Silverlode76/SmartGarden/hardware/schematics/lilygo-t3/lilygo-t3-v1.6.1-pinout.png

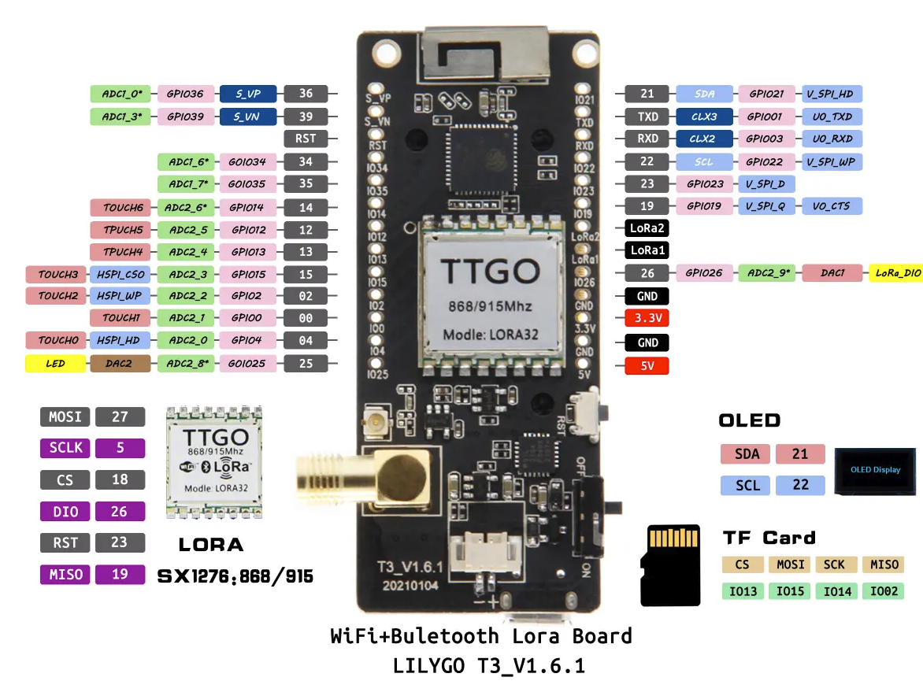
hardware/schematics/lilygo-t3/lilygo-t3-v1.6.1-pinout.png
