Silverlode76/SmartGarden/docs/product/SmartGarden-Pitch.pptx

🌱

SmartGarden

Off-Grid Smart Gardening Ökosystem

Solar-betrieben · LoRaWAN-vernetzt · Kein WLAN · Kein Strom nötig

Oliver Schmoll · Technical Product Manager · 2026

## Slide 2

Das Problem

🌱

Der Gärtner

- Pflanzen sterben im Urlaub
- Lösungen brauchen Wasserhahn mit Druck
- Off-Grid = keine funktionierende Lösung

🔒

Der Laubenbesitzer

- Einbrüche in Gartenlauben nehmen zu
- Wildkamera: Foto ja — Sofort-Alarm nein
- Keine Alarmanlage ohne Strom + WLAN

🏗️

Der Gewerbetreibende

- Baumaschinen, Holz, Weinberge gestohlen
- GSM-Alarme teuer + monatliche Kosten
- Kein LoRaWAN-Angebot am Markt

## Slide 3

Zwei spezialisierte Produkte

🌱 SmartGarden Garden Home

~65€ · Irrigator Node

- Bodenfeuchte messen
- Automatisch pumpen
- Per App steuern

Kein Wasserhahn · Solar · LoRaWAN

🔒 SmartGarden Guard Home

~45€ · Guard Node

- Bewegung + Erschütterung erkennen
- Sofortiger Push-Alarm aufs Handy
- Ohne WLAN · ohne Monatskosten

Kein WLAN · Solar · Jahre ohne Wartung

🌱🔒 SmartGarden Bundle ~100€ · Irrigator + Guard · Eine App · Ein Gateway

## Slide 4

Marktlücke — niemand hat alles

Feature

MIYO (~250€)

Gardena AquaBloom (~80€)

SmartGarden (~65€)

Pumpe (kein Wasserhahn)

❌

✅

✅

App / Fernzugriff

✅

❌

✅

Bodenfeuchtesensor

✅

❌

✅

LoRaWAN (kein WLAN)

✅

❌

✅

Einbruchalarm / PIR

❌

❌

✅

Open Source

❌

❌

✅

Preis

~250€

~80€

~65€

## Slide 5

Marktpotenzial Europa

4,2 Mio.

Off-Grid Standorte
in Europa

862 Mio. €

TAM Hardware
Europa

3,0 Mio. €

SaaS ARR
bei 2% Penetration

## Slide 6

Der Markt wird konsolidiert

Ring

→ Amazon 2018

~1 Mrd. $

Consumer Security IoT

Netatmo

→ Legrand 2018

~70 Mio. €

Smart Home IoT

Gardena

→ Husqvarna lfd.

>800 Mio. € Umsatz

Bewässerungssysteme

MIYO

→ Startup aktiv

~5 Mio. € Finanzierung

LoRaWAN Bewässerung

Niemand hat das off-grid Segment mit Pumpe + Alarm — das ist die Lücke.

## Slide 7

Technologie-Stack

☀️ Solar 6W + 2× 18650
Autarke Stromversorgung

↓

←

🌱 Garden Node
Bodenfeuchte + 12V Pumpe

TTGO LoRa32 V2.1
ESP32 + SX1276 · 868 MHz

→

🔒 Guard Node
PIR AM312 + SW-420

↓

LoRaWAN 868 MHz
TTN Gateway

→

Cloud Backend
REST API + Regelwerk

→

📱 App
iOS + Android (Flutter)

KiCad 10 Schaltplan fertig · ERC: 0 Errors · Open Source: github.com/Silverlode76/SmartGarden

## Slide 8

Roadmap

TP4056 → CN3791, STM32 → ESP32 — Erkenntnisse dokumentiert

✅

v0.0 (2025)

Prototyp STM32 + SX1276

✅

v0.1 (2026 Q1)

ERC: 0 Errors · 5 Blöcke · Open Source auf GitHub

KiCad Schaltplan + BOM + Anleitung

🔄

v0.2 (2026 Q2)

Garden Home Prototyp

Pumpe + Bodenfeuchte + LoRaWAN + Deep Sleep

⬜

v0.3 (2026 Q3)

Guard Home Prototyp

PIR + Vibration + AND-Logik + Push-Alarm

⬜

v0.4 (2026 Q3)

App MVP (Flutter)

Beide Nodes · Push-Alarm · iOS + Android

⬜

v1.0 (2027 Q2)

Markteinführung

Amazon FBA · Bundle · App Store Release

## Slide 9

Go-to-Market in 4 Phasen

2026

DIY & Community

- GitHub Open Source
- Maker-Blogs + YouTube
- Ziel: 100 Nodes

1

2026–2027

Kleingartenvereine

- 1 Gateway = ganzer Verein
- Viral: 1 Pilot → alle
- Ziel: 10 Pilotvereine

2

2027

Amazon FBA

- DE + AT + CH
- Hornbach / Baumarkt
- Ziel: 5.000 Nodes/Jahr

3

2028+

B2B & OEM

- Guard Field: Winzer/Baustellen
- OEM-Lizenz an Hersteller
- Ziel: Lizenzeinnahmen

4

## Slide 10

Erfahrung

22+ Jahre Automotive (Continental)

Ausbildung

Oliver
Schmoll

Technical Product Manager

Diplom-Ingenieur Informationstechnologie

Sprachen

Deutsch · Englisch · Französisch

Zertifizierungen

Microsoft AI PM · AWS Cloud · NVIDIA Gen AI

SmartGarden

Hardware · Firmware · Strategie · Open Source

🔗 github.com/Silverlode76/SmartGarden
🔗 linkedin.com/in/oliver-schmoll-8b4109273
