Silverlode76/SmartGarden/hardware/schematics/v0.0-gateway/STM32_LoRa_Wifi_Gateway_Schaltplan.png

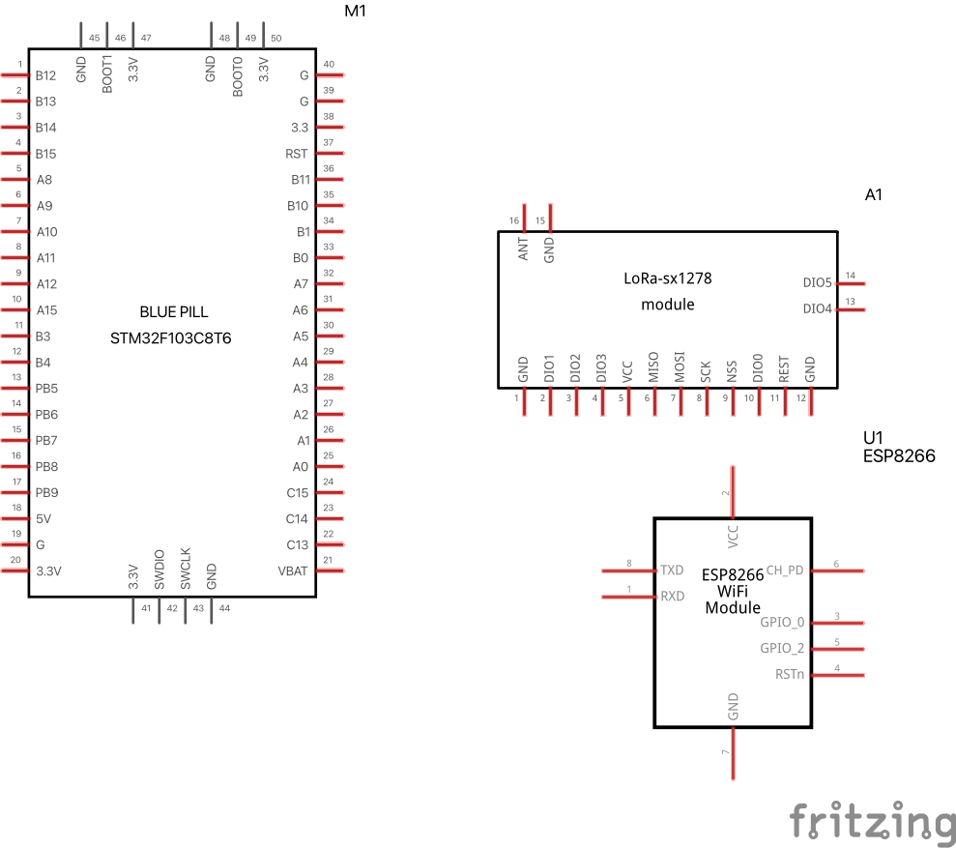
hardware/schematics/v0.0-gateway/STM32_LoRa_Wifi_Gateway_Schaltplan.png
