Silverlode76/SmartGarden/hardware/bom/v0.0-stm32-prototype-bom.md

# Stückliste — Prototyp v0.0 (STM32 + SX1278)

**Datum:** 2025 (genaues Datum unbekannt)  
**Designer:** Oliver Schmoll  
**Tool:** Fritzing (Lochrasterplatine)  
**Status:** Archiviert — abgelöst durch v0.1 (TTGO LoRa32)  
**Erkenntnisse:** Dokumentiert in [ADR-001](../../docs/architecture/ADR-001-MCU-Auswahl.md)

## Quelldokumente (archiviert)

| Datei | Beschreibung |
|---|---|
| [`STM32_LoRa_Slave_Steckplatine.pdf`](STM32_LoRa_Slave_Steckplatine.pdf) | Fritzing Steckplatinen-/Lochrasteransicht |
| [`STM32_LoRa_Slave_Schaltplan.pdf`](STM32_LoRa_Slave_Schaltplan.pdf) | Fritzing Schaltplan |

> Diese Dateien sind die **Primärquelle** für den v0.0-Prototypen.

---

## Stückliste

| Ref. | Bezeichnung | Typ | Eigenschaften | Menge |
|---|---|---|---|---|
| A1 | LoRa SX1278 Modul | LoRa Transceiver Breakout | SX1278; THT; 433 MHz (!); Pinabstand 2,54mm | 1 |
| Bauteil1 | GY-BME280 | Barometrischer Drucksensor | Temperatur + Luftfeuchte + Luftdruck; I2C; 3,3V | 1 |
| Bauteil2 | Solarzelle | Photovoltaik-Zelle (klein) | 1,5V / 1mA (0,0015W); Einzelzelle | 1 |
| Bauteil3 | Solarzelle | Photovoltaik-Zelle (klein) | 1,5V / 1mA (0,0015W); Einzelzelle | 1 |
| J1 | Female Header 4-polig | Steckverbinder | THT; 2,54mm; 4-Pin; für Sensor-Breakout | 1 |
| J2 | Female Header 4-polig | Steckverbinder | THT; 2,54mm; 4-Pin; für Sensor-Breakout | 1 |
| M1 | STM32F103C8T6 Blue Mini Board | Mikrocontroller-Board | „Blue Pill"; ARM Cortex-M3; 72MHz; 64KB Flash; 20KB RAM | 1 |
| R1 | Widerstand 10 kΩ | Widerstand | ±5%; 0,25W; THT; 4-Band; 400mil — I²C Pull-up SDA | 1 |
| R2 | Widerstand 10 kΩ | Widerstand | ±5%; 0,25W; THT; 4-Band; 400mil — I²C Pull-up SCL | 1 |
| TP1 | TP4056 | LiPo Laderegler | DIP-6; THT; max. 1A Ladestrom; Vmin ~4,5V Eingang | 1 |
| U1 | LiPo 110mAh | Lithium-Polymer Akku | 3,7V; 110mAh (= 0,407 Wh); interne R = 0,1Ω; Paket lipo-110 | 1 |
| U2 | Mini-360 DC-DC Buck Converter | Spannungsregler (Abwärtswandler) | Eingang bis 23V; Ausgang einstellbar; THT-Modul; kein MPPT | 1 |

---

## Gesamtkosten (geschätzt)

| Position | Kosten ca. |
|---|---|
| STM32F103C8T6 Blue Pill | ~3,50 € |
| LoRa SX1278 Modul | ~3,00 € |
| GY-BME280 Breakout | ~3,00 € |
| TP4056 Laderegler | ~0,50 € |
| Mini-360 Buck Converter | ~1,50 € |
| LiPo 110mAh | ~3,00 € |
| 2× Solarzelle | ~2,00 € |
| Sonstiges (R, Stecker, PCB) | ~2,00 € |
| **Gesamt** | **~18,50 €** |

---

## Schaltungskonzept (aus Fritzing-Steckplatine)

```
[2× Solarpanel, je ~3–3,5V OC]   In Reihe: ~6V / "7V" OC (Fritzing-Label)
             |
    [Mini-360 Buck Converter]      Eingang: ~6V Solar
         "6V" Label                Ausgang: einstellbar ~5V → für TP4056
             |
       [TP4056 Laderegler]         Benötigt ~4,5–5V Eingang; lädt LiPo
             |
     [LiPo 110mAh 3,7V]           Akku-Typ: 6SP 061225
             |                     (direkter GND-Anschluss an Lochrasterplatine)
             └─────────────────────────────────────────┐
                                                        |
[Lochrasterplatine]                                     |
   [STM32F103C8T6 Blue Pill] ←────────── 3,3V (vom 3V3-Pin des Blue Pill)
          │
          ├──I²C (SDA/SCL + 2× 10kΩ Pull-up)────[GY-BME280 (lila)]
          │
          └──SPI (MOSI/MISO/SCK/NSS + DIO0/DIO1)──[SX1278 LoRa Modul (blau rechts)]
                                                         → 433 MHz proprietär

Debug-Ausgang: USART3 → PB10 (TX) / PB11 (RX)
```

> **Hinweis zu Spannungsannotationen:** In der Fritzing-Steckplatine sind die Labels  
> „6V" und „7V" vom Designer manuell gesetzt. „7V" = Solar-Leerlaufspannung (OC),  
> „6V" = Betriebsspannung an Mini-360-Eingang. Die Fritzing-Bauteilbibliothek listet  
> die Solar-Zellen mit „1,5V/1mA" (Standardwert des Fritzing-Bauteils) — das spiegelt  
> **nicht** die reale Betriebsspannung wider. Tatsächlich verwendete Panels: ~3V/Stück  
> in Reihe = ~6V, aber mit sehr geringem Strom → TP4056 arbeitete grenzwertig.

---

## Erkenntnisse aus diesem Prototyp

### ✅ Was funktionierte

- STM32F103C8T6 grundsätzlich lauffähig
- BME280 liefert gute Messwerte (Temp, Feuchte, Luftdruck)
- LoRa-Kommunikation (proprietäres Protokoll) funktionsfähig
- Konzept der solarbetriebenen Node validiert

### ⚠️ Kritische Probleme

| Problem | Ursache | Lösung in v0.1 |
|---|---|---|
| **SX1278 = 433 MHz** (nicht EU868) | SX1278 Frequenzbereich 137–525 MHz → kein LoRaWAN EU868 möglich | TTGO LoRa32 mit SX1276 (137–1020 MHz), EU868-fähig |
| **Solarzellen viel zu schwach** | 2× 1,5V / 1mA in Reihe = 3,0V / 1mA = **0,003W** — für Laderegler wertlos | 6W 6V Solarpanel (~1A) |
| **TP4056 lädt nicht bei Schwachlicht** | TP4056 benötigt Vmin ~4,5V — 3V Solarspannung reicht nicht | CN3791 MPPT startet ab ~4V, effizienter bei diffusem Licht |
| **Kein MPPT** | Mini-360 ist einfacher Buck-Converter, kein Maximum-Power-Point-Tracking | CN3791 MPPT-IC |
| **110mAh viel zu klein** | 110mAh bei ~5mA Standby = ~22h Autonomie ohne Solar | 2× 18650 (~5000mAh) → ~1000h Autonomie |
| **Kein LoRaWAN** | Eigenes proprietäres Protokoll, kein TTN möglich | LoRaWAN + MCCI LMIC Library |
| **STM32 Toolchain komplex** | STM32CubeIDE, HAL, manuelle SPI-Konfiguration für SX1278 | ESP32 + Arduino Framework → schnellere Iteration |

### ❌ Warum abgelöst

Der Prototyp hat bewiesen, dass das **Konzept** funktioniert.  
Die **Plattform** (STM32 + SX1278 + TP4056 + 110mAh) ist für ein Outdoor-Solar-Produkt ungeeignet.  
→ Vollständiger Plattformwechsel auf ESP32 + SX1276 (TTGO LoRa32) für v0.1.

---

## Abgrenzung zu v0.1 BOM

| Parameter | v0.0 (STM32) | v0.1 (TTGO LoRa32) |
|---|---|---|
| MCU | STM32F103C8T6 | ESP32 (im TTGO) |
| LoRa | SX1278 (433 MHz) | SX1276 (868 MHz, EU) |
| Protokoll | Proprietär | LoRaWAN / TTN |
| Laderegler | TP4056 (kein MPPT) | CN3791 MPPT |
| Akku | LiPo 110mAh | 2× 18650 ~5000mAh |
| Solar | 2× 1,5V/1mA = 3mW | 6W 6V Panel ~1A |
| Toolchain | STM32CubeIDE + HAL | PlatformIO + Arduino |
| Autonomie (ohne☀️) | ~22h | ~1000h (~42 Tage) |
| BOM-Kosten | ~18,50€ | ~35–50€ |

---

> **Hinweis zu ADR-001:** In ADR-001 (MCU-Auswahl) wurde der Prototyp aus dem Gedächtnis beschrieben.  
> Diese BOM ist die Primärquelle (Fritzing-Exportdatei). Abweichungen:  
> - ADR-001 nennt „SX1276" — tatsächlich verbaut: **SX1278** (433 MHz)  
> - ADR-001 nennt „1× 18650" — tatsächlich verbaut: **LiPo 110mAh**  
> - ADR-001 nennt „2× Solarpanel 6V" — tatsächlich verbaut: **2× Zelle 1,5V/1mA**
