Silverlode76/SmartGarden/hardware/schematics/sensor-node/Schematic.pdf

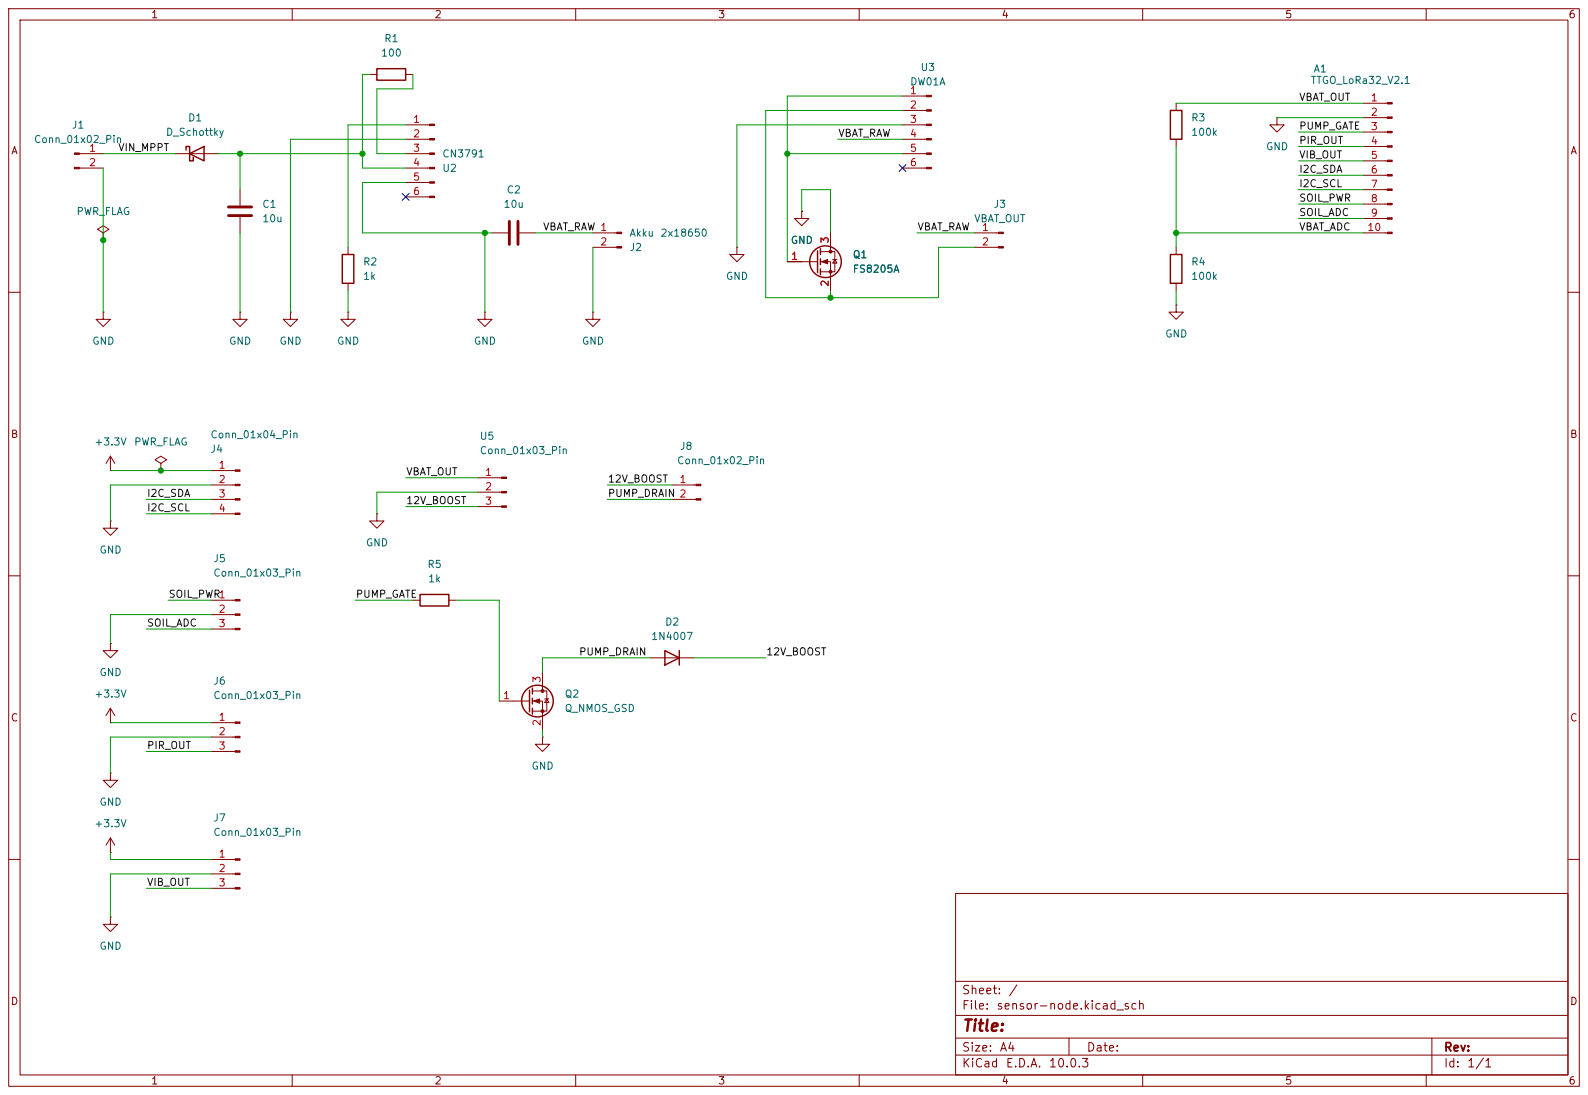
[picture p3: page 1]

Size: A4 | Rev:
KiCad E.D.A. 10.0.3 | Id: 1/1
