Silverlode76/SmartGarden/hardware/schematics/v0.0-gateway/STM32_LoRa_Wifi_Gateway_etch_copper_bottom.pdf

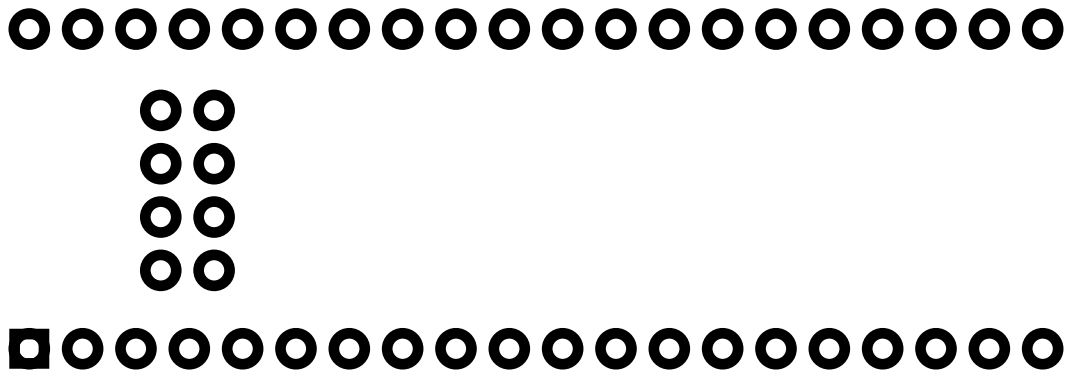
[picture p4: page 1]
