Silverlode76/SmartGarden/hardware/schematics/v0.0-gateway/STM32_LoRa_Wifi_Gateway_etch_silk_top.pdf

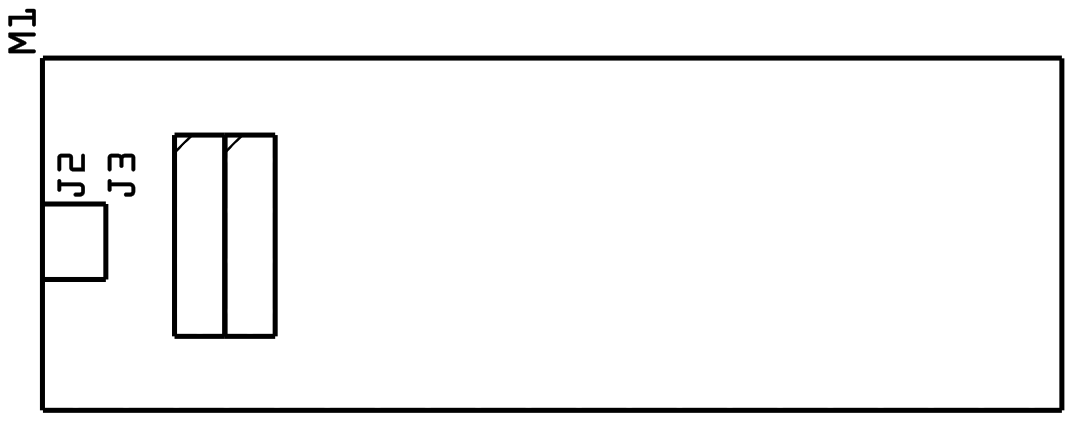
[picture p5: page 1]
