Silverlode76/SmartGarden/hardware/schematics/v0.0-stm32-slave/STM32_LoRa_Slave_Schaltplan.pdf

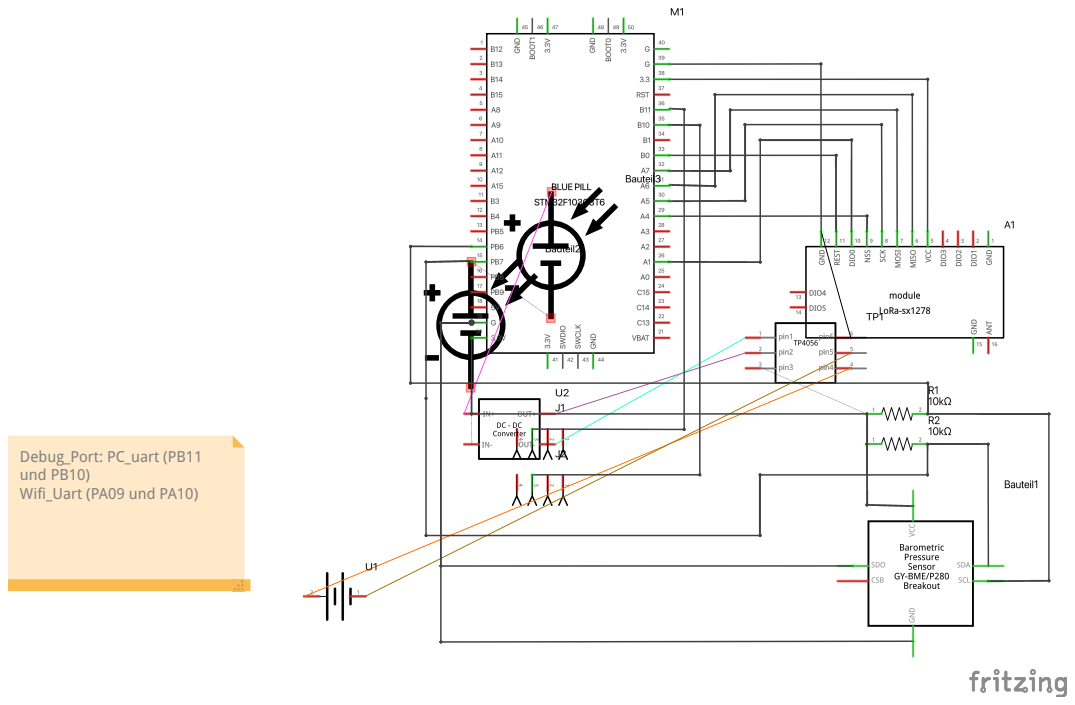
[picture p6: page 1]
Debug_Port: PC_uart (PB11 und PB10) Wifi_Uart (PA09 und PA10)
