Silverlode76/SmartGarden/hardware/schematics/v0.0-stm32-slave/STM32_LoRa_Slave_Steckplatine.pdf

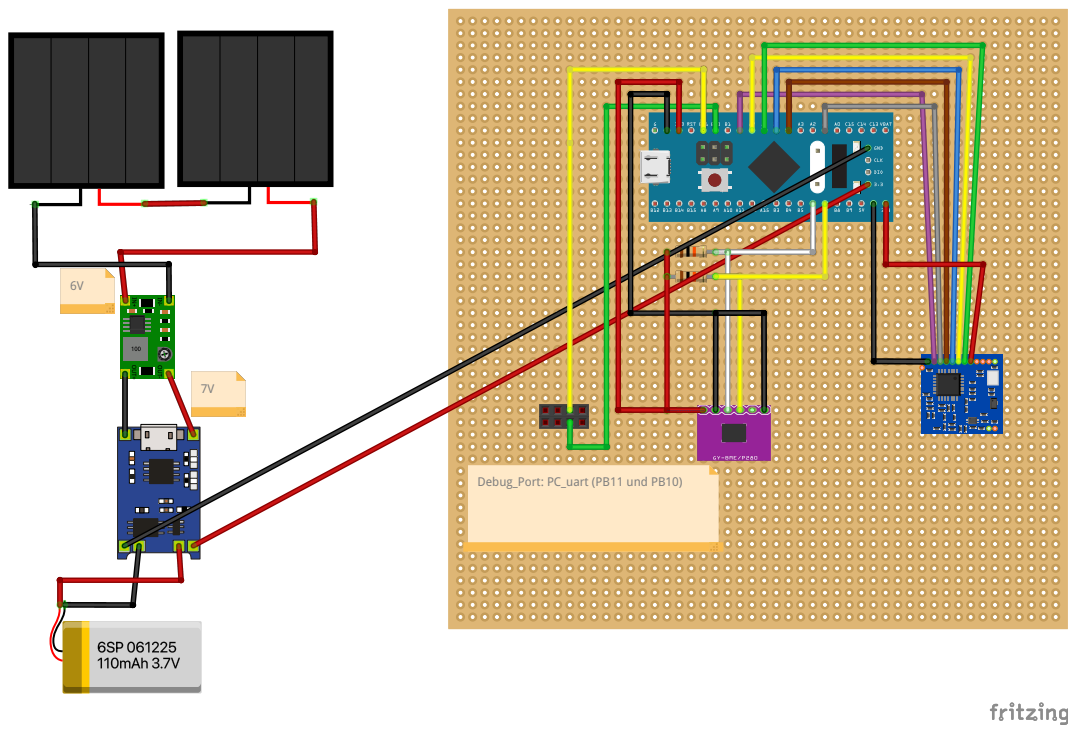
[picture p7: page 1]
Debug_Port: PC_uart (PB11 und PB10)
