Silverlode76/SmartGarden/(list of files, drawings)

Other design files:
hardware/schematics/v0.0-gateway/STM32_LoRa_Wifi_Gateway.fzz
