Silverlode76/SmartGarden/hardware/schematics/sensor-node/sensor-node.kicad_sch

## KiCad design hardware/schematics/sensor-node/sensor-node.kicad_sch (2026-05-25)

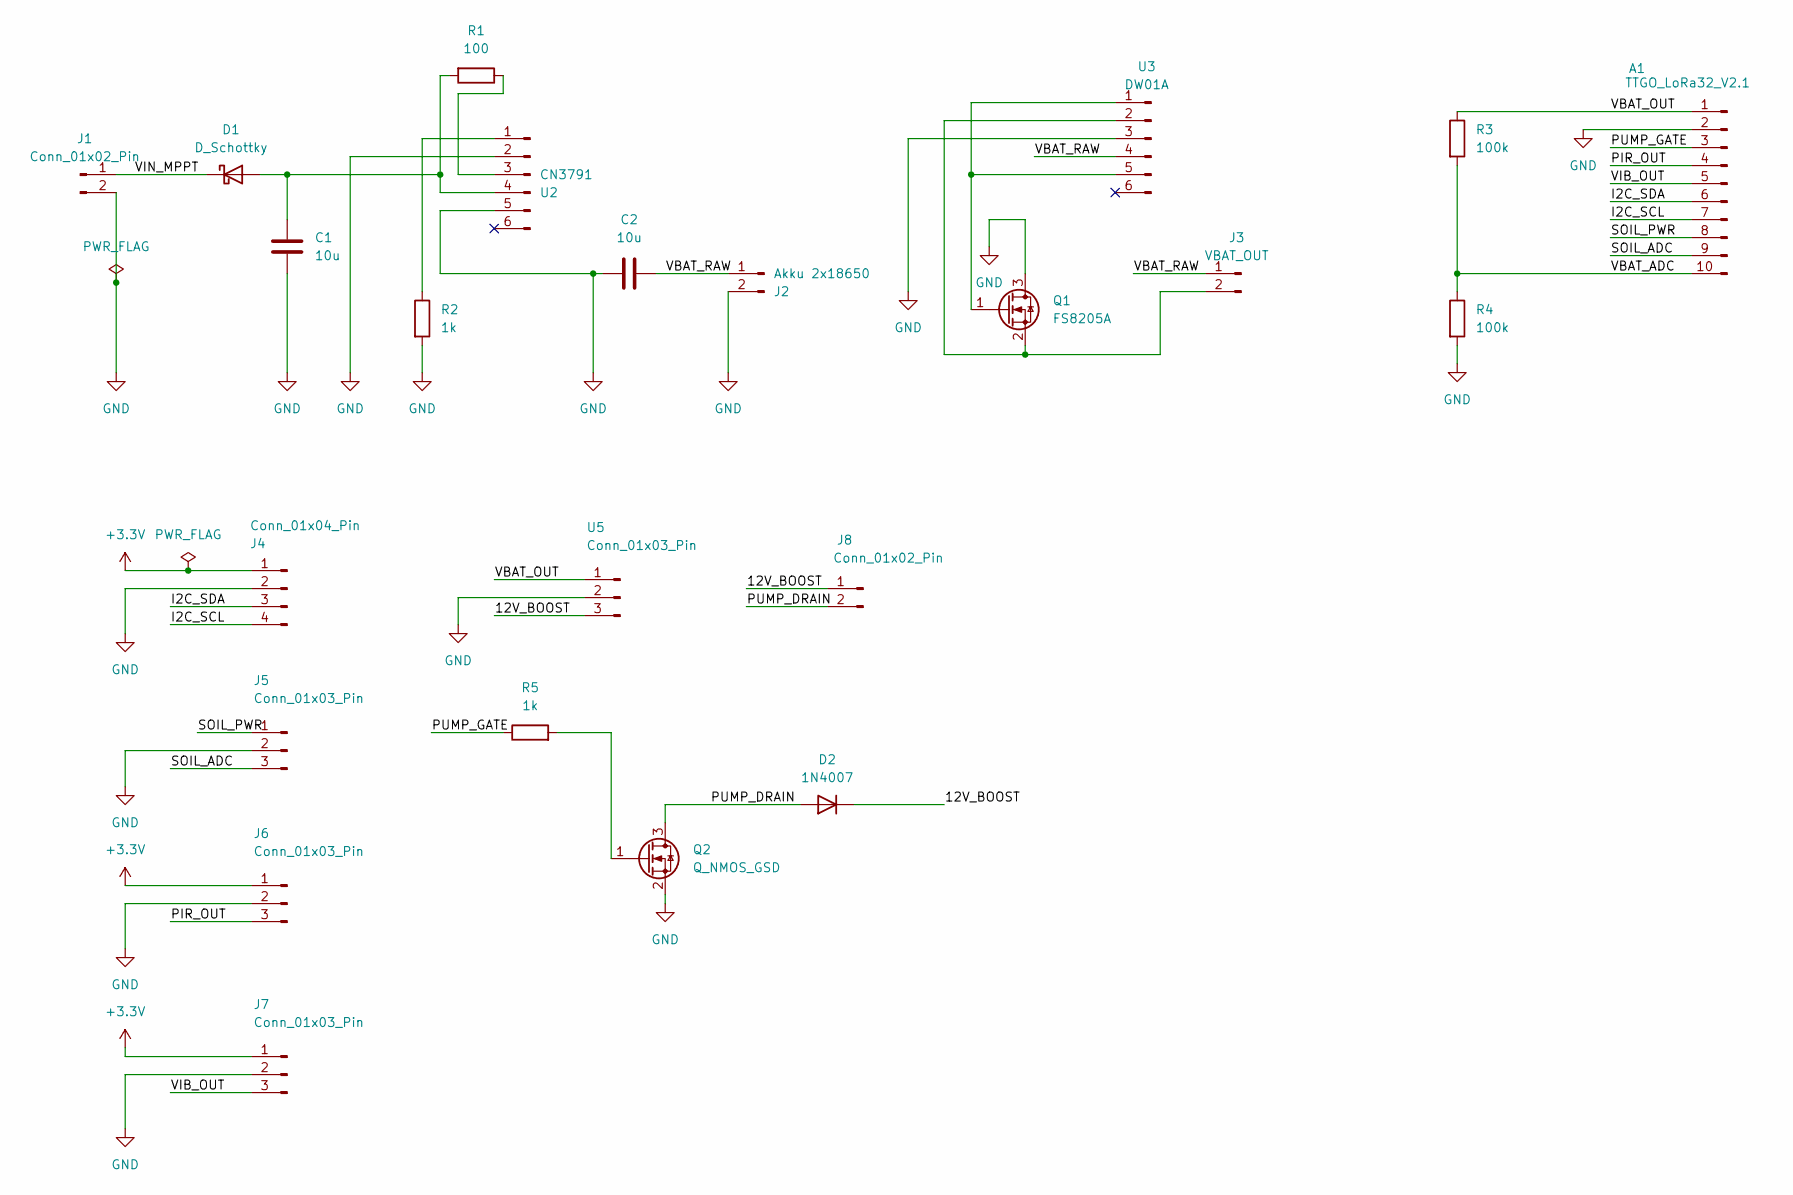
[picture p8: schematic sensor-node.kicad_sch]

Parts:
A1: TTGO_LoRa32_V2.1
C1, C2: 10u
D1: D_Schottky
D2: 1N4007; D_DO-41_SOD81_P10.16mm_Horizontal
J1, J8: Conn_01x02_Pin
J2: Akku 2x18650
J3: VBAT_OUT
J4: Conn_01x04_Pin
J5, J6, J7: Conn_01x03_Pin
Q1: FS8205A
Q2: Q_NMOS_GSD
R1: 100
R2, R5: 1k
R3, R4: 100k
U2: CN3791
U3: DW01A
U5: Conn_01x03_Pin

Connections:
12V_BOOST: D2.1 (K), J8.1, U5.3
+3.3V: J4.1, J6.1, J7.1
GND: A1.2, C1.1, C2.2, J1.2, J2.2, J4.2, J5.2, J6.2, J7.2, Q1.3 (D), Q2.2 (S), R2.2, R4.2, U2.2, U2.5, U3.3, U5.2
I2C_SCL: A1.7, J4.4
I2C_SDA: A1.6, J4.3
unnamed: C1.2, D1.2 (A), R1.2, U2.4
unnamed: J3.2, Q1.2 (S), U3.2
unnamed: Q1.1 (G), U3.1, U3.5
unnamed: Q2.1 (G), R5.2
unnamed: R1.1, U2.3
unnamed: R2.1, U2.1
PIR_OUT: A1.4, J6.3
PUMP_DRAIN: D2.2 (A), J8.2, Q2.3 (D)
PUMP_GATE: A1.3, R5.1
SOIL_ADC: A1.9, J5.3
SOIL_PWR: A1.8, J5.1
VBAT_ADC: A1.10, R3.2, R4.1
VBAT_OUT: A1.1, R3.1, U5.1
VBAT_RAW: C2.1, J2.1, J3.1, U3.4
VIB_OUT: A1.5, J7.3
VIN_MPPT: D1.1 (K), J1.1
