Silverlode76/SmartGarden/firmware/v0.0-stm32-node/Core/Inc/main.h

#define LED_Pin GPIO_PIN_13
#define LED_GPIO_Port GPIOC
#define DIO0_Pin GPIO_PIN_1
#define DIO0_GPIO_Port GPIOA
#define DIO0_EXTI_IRQn EXTI1_IRQn
#define NSS_Pin GPIO_PIN_4
#define NSS_GPIO_Port GPIOA
#define RST_Pin GPIO_PIN_0
#define RST_GPIO_Port GPIOB
