Silverlode76/SmartGarden/(commit log)

2026-05-24 initiale Projektstruktur mit Docs, Requirements und Architecture
2026-05-24 docs: ADR-001 MCU-Entscheidung und Prototyp-Erkenntnisse dokumentieren
    Erfahrungen aus dem v0.0-Prototyp (STM32 + SX1276 + BME280) fließen
    in die Architekturentscheidungen für v0.1 ein: Wechsel zu ESP32 mit
    integriertem LoRa-Modul, LoRaWAN statt eigenem Protokoll, BME280 als
    Standard-Sensor statt DHT22.
2026-05-25 feat: Sensor-Node v0.1 Schaltplan + Hardware-Architektur vollständig
    ## Hardware-Architektur (docs/)
    - README: Off-Grid Smart Irrigation Positionierung, Gardena AquaBloom als Wettbewerber ergänzt
    - hardware-overview.md: Vollständige Schaltplan-Dokumentation (5 Blöcke: Ladekreis, Akkuschutz, TTGO, Sensoren, Pumpe)
    - ADR-001: Prototyp-Erkenntnisse dokumentiert (STM32→ESP32, TP4056→CN3791 MPPT, Schwachlicht-Problem)
    - competitive-analysis.md: Gardena AquaBloom Analyse, Off-Grid Zielgruppen, 3-Wege USP-Vergleich
    - agent-prompts.md: Architekt-Agent mit aktuellem Tech-Stack (CN3791, AM312, BME280, 2P-Akku)
    ## KiCad Schaltplan (hardware/schematics/sensor-node/)
    - Block A: CN3791 MPPT Ladek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
    [sensor-node-bom.csv, sensor-node.kicad_sch]
2026-05-25 Sensor-Node v0.1 — KiCad Schaltplan + Hardware-Architektur
    ## Was wurde gemacht
    - KiCad Schaltplan sensor-node vollständig gezeichnet (5 Blöcke, ERC: 0 Errors)
    - Hardware-Architektur Dokumentation aktualisiert
    - BOM (Stückliste) erstellt ~50€ pro Node
    ## Schaltplan Blöcke
    - **Block A:** CN3791 MPPT Ladekreis (SS14 + R_MPPT + R_PROG)
    - **Block B:** DW01A + FS8205A Akkuschutz (OVP/UVP/OCP)
    - **Block C:** TTGO LoRa32 V2.1 (10 GPIOs + VBAT Spannungsteiler)
    - **Block D:** Sensoren (BME280, Bodenfeuchte, AM312 PIR, SW-420)
    - **Block E:** Pumpensteuerung (XL6009 + IRLZ44N + 1N4007)
    ## Nächste Schritte
    - [ ] Lochraster-Aufbau v0.1
    - [ ] PlatformIO Firmware-Projekt
2026-05-25 HW Layout
    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
2026-05-25 docs: Sensor-Node Aufbauanleitung (Lochraster v0.1)
    Schritt-für-Schritt Löt- und Testanleitung für alle 5 Blöcke:
    Block A (CN3791 Ladekreis), B (DW01A Akkuschutz), C (TTGO LoRa32),
    D (Sensoren), E (Pumpensteuerung XL6009 + IRLZ44N)
    Enthält: Werkzeugliste, Sicherheitshinweise, Testpunkte mit
    erwarteten Spannungen, typische Fehler & Lösungen.
2026-05-25 docs: README für Portfolio optimiert + MIT License hinzugefügt
    - Badges (License, KiCad, Platform, Status)
    - Problemstellung und Lösung klar strukturiert
    - Hardware-Architektur Tabelle mit Tech-Stack
    - Energiebudget-Tabelle
    - Prototyp-Erkenntnisse v0.0 dokumentiert
    - Vollständige Projektstruktur mit Links
    - Roadmap mit abgeschlossenen Meilensteinen
2026-05-27 Add product portfolio: Irrigator + Guard + Bundle
    Introduces two-product architecture based on physical separation of use cases:
    - Irrigator (~65€): soil sensor + pump + LoRaWAN for gardeners
    - Guard (~45€): PIR + vibration + alarm for shed/cabin owners
    - Bundle (~100€): both products for allotment garden owners with shed
    Adds docs/product/product-strategy.md with full market analysis, pricing,
    go-to-market strategy and risk assessment. Updates README and roadmap.
2026-05-27 Expand product strategy into two distinct product lines
    Garden line: Home (65€) + Pro (120€, multi-zone)
    Guard line: Home (45€) + Field (80€, vineyard/construction + wildlife camera trigger) + Asset (95€, GPS tracking for machinery)
    Key additions:
    - Wildkamera integration via optocoupler trigger output on Guard Field
    - AND-logic alarm filtering to prevent false alarms
    - Separate ECU architectures per product
    - Expanded market segments: vineyards, forestry, construction sites
    - Guard Field addresses wood theft / vineyard theft use cases
2026-05-28 Add extended market analysis to product strategy
    - European TAM: ~862M€ hardware across 4.2M off-grid sites
    - SaaS ARR projection: 756K€ (conservative) to 7.6M€ (optimistic)
    - 3-year revenue model: 35K€ → 344K€ → 1.3M€
    - Break-even analysis: ~2,000 nodes / end of 2027
    - Comparable exits: Netatmo (70M€), Ring (1B$), Gardena (800M€ revenue)
    - Competitive positioning matrix
2026-05-28 Add SmartGarden pitch deck (10 slides)
    Professional pitch deck covering:
    - Product portfolio: Garden Home + Guard Home + Bundle
    - Problem/Solution with 3 customer segments
    - Competitive analysis table (MIYO vs. Gardena vs. SmartGarden)
    - European market sizing: 4.2M sites / 862M€ TAM / 3.0M€ SaaS ARR
    - Comparable exits: Ring/Amazon, Netatmo/Legrand, Gardena/Husqvarna
    - Technology architecture flow
    - Roadmap v0.0 → v1.0
    - Go-to-Market in 4 phases
    - Developer profile
2026-05-28 Add Guard battery monitoring user stories (US-020 to US-023)
    US-008: Expand Garden battery display with full acceptance criteria
    US-020: Guard battery % + estimated remaining runtime (no solar)
    US-021: 3-tier push alarm at 25% / 10% / 3% with special low-battery payload
    US-022: Node offline detection with context (dead battery vs. possible theft)
    Key insight: last known battery level distinguishes both cases
    US-023: Charging history + maintenance reminder (like smoke detector battery)
    All Guard stories reflect batteryless design: 1-1.5 year runtime on 2x18650.
2026-05-28 Add 3-phase hardware path and Custom PCB ADR (ADR-002)
    Phase 1 (PoC): TTGO Dev-Board, BOM Guard ~47€, sell ~89€
    Phase 2 (Pilot): TTGO Bulk @12€, BOM Guard ~32€, sell ~65€
    Phase 3 (Production): Custom PCB ESP32-WROOM-32E + SX1262, BOM Guard ~18€, sell ~45€
    ADR-002: Documents why TTGO (21€ Einzelbezug) makes Guard target
    price (45€) impossible. Custom PCB via JLCPCB/PCBWay from KiCad
    Gerbers reduces BOM from ~47€ to ~18€. Rejected alternatives
    documented (bare ESP32 chip, RAK WisBlock, Nordic nRF9160, STM32).
2026-05-28 Add Garden Home PoC firmware (PlatformIO + MCCI LMIC)
    TTGO LoRa32 V2.1 — ESP32 + SX1276 — EU868 / TTN OTAA
    Features:
    - OTAA Join via TTN (The Things Network)
    - Uplink alle 60s: 1 Byte LED-Status (Port 1)
    - Downlink: LED an (0x01) / aus (0x00) / toggle (0x02)
    - OLED-Display: Join-Status, TX-Counter, RSSI, LED-State
    - Adaptive Data Rate (ADR) aktiviert
    - secrets.h in .gitignore (Credentials nie im Git)
    Nächste Schritte:
    - secrets.h aus TTN Console befüllen
    - platformio run --target upload
2026-05-28 Document v0.0 STM32 prototype BOM and correct ADR-001
    BOM source: Fritzing export from first prototype build
    Corrects ADR-001 which was written from memory:
    - LoRa chip: SX1278 (433 MHz), not SX1276 (EU868)
    - Battery: LiPo 110mAh, not 18650
    - Solar: 2× 1.5V/1mA cells (3mW total), not 6V panels
    - No MPPT: Mini-360 Buck converter only
    - Consequence: ~22h autonomy without sun, EU868 not possible
    BOM includes: STM32F103C8T6 Blue Pill, SX1278, GY-BME280,
    TP4056, LiPo 110mAh, Mini-360 Buck, 2× 10kΩ, female headers
2026-05-28 Archive v0.0 Fritzing files and document full system architecture
    Slave node (STM32 + SX1278):
    - Archive Fritzing schematic + breadboard PDFs
    - Correct power chain from image: Solar ~6V → Mini-360 Buck → TP4056 → LiPo
    - Clarify Fritzing library default (1.5V/1mA) vs actual voltage labels (6V/7V)
    - Debug UART confirmed: USART3 PB10(TX)/PB11(RX)
    Master/Gateway (ESP32 + STM32 + SX):
    - Document dual-MCU architecture: STM32 handles LoRa SPI timing,
    ESP32 handles WiFi + cloud upload, UART bridge between them
    - Document proprietary 433MHz protocol flow
    - Compare v0.0 (proprietary) vs v0.1+ (LoRaWAN/TTN) architecture
    Key learnings: dual-MCU gateway works but doesn't scale,
    proprietary prot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
2026-05-28 Correct and complete v0.0 master gateway documentation
    Key correction: Master used ESP8266 (not ESP32) as WiFi module
    - ESP8266 ESP-01 form factor, UART bridge to STM32
    - STM32 handled LoRa SPI stack + packet parsing
    - Full stack proven: LoRa → STM32 → UART → ESP8266 → Google Cloud → Flutter app
    Pin mapping documented from Fritzing schematic:
    - SX1278 SPI: PA4-PA7 + DIO0 IRQ
    - ESP8266 UART: PA9/PA10 (USART1)
    Architecture comparison added: v0.0 (proprietary) → v0.1 (LoRaWAN) → v1.0 (product)
    Key insight: Cloud+Flutter stack was already proven in v0.0
2026-05-28 Complete v0.0 architecture documentation with full system diagrams
    Revealed from architecture diagrams:
    - Gateway was Raspberry Pi + SX1302 (8-channel LoRa concentrator, not just ESP8266)
    - UUID-based device addressing (uuid1=node1, uuid2=node2, uuid3=gateway)
    - Google Cloud IoT Core as MQTT broker (bidirectional)
    - Firebase for data storage
    - Flutter app via MQTT
    - Bidirectional LoRa (uplink + downlink capable)
    Boot sequence documented (STM32+ESP8266):
    - STM32 initializes ESP8266 first
    - ESP8266 connects WiFi AP (retry loop)
    - ESP8266 connects Firebase (retry loop)
    - Only after confirmed cloud connection: STM32 inits LoRa
    - Ensures no packet loss on startup
    Key insight: v0.0 was architect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
2026-05-28 Archive v0.0 gateway firmware, Fritzing PCB and schematic
    Firmware (STM32F103C8T6 + ESP8266, STM32CubeIDE):
    - AT command sequence: CWMODE=1 → CWJAP → CIPMUX=1 → CIPSERVER:80
    - USART3 (PB10/PB11) @ 115200 baud to ESP8266
    - TCP web server on port 80 (local network access)
    - WiFi credentials REMOVED (were hardcoded in original - Lesson Learned)
    - LoRa (SX1278) was TODO - WiFi init was first milestone
    Fritzing PCB (designed Dec 24, 2024):
    - Full gateway PCB layout: copper top/bottom, silk screen
    - STM32F103C8T6 + SX1278 + ESP8266 on one board
    - .fzz source file + key PCB layer PDFs archived
    Lessons learned documented:
    - Credentials → always secrets.h + .gitignore (fixed in v0.1)
    - AT-m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
    [STM32_LoRa_Wifi_Gateway.fzz]
2026-05-28 Correct v0.0 gateway: STM32+ESP32 dual-MCU, not Raspberry Pi+SX1302
    Actual hardware (confirmed by user):
    - STM32F103C8T6 (CubeIDE HAL): LoRa SX1278 SPI stack
    - ESP32 (Arduino framework): WiFi + Firebase connectivity
    - UART bridge between STM32 and ESP32
    Firebase details from archived code:
    - DB: collectxcpandlora-default-rtdb.firebaseio.com
    - Downlink path: /sensor_commands/txpk/0/decoded_data/LED
    - ESP32 polls Firebase every 15s for LED commands
    - WiFi credentials stored in EEPROM (not hardcoded)
    Performance confirmed by user: 3km range, bidirectional
    LED control working (master sends ON/OFF, slave responds)
2026-05-28 Archive complete v0.0 STM32 LoRa node firmware (STM32_myLora)
    Full STM32CubeIDE project with MASTER/SLAVE dual-role firmware,
    HAL SPI LoRa stack (Sslman Motlaq), BME280 driver, bidirectional LED
    control protocol at 868 MHz, DIO0 interrupt-driven receive, STOP-mode
    sleep on slave. Confirmed 3 km field range.
2026-05-28 ADR-003: Pump selection — min. 3m head required, upgrade to 10W
    Prototype test revealed cheap 3-5W pump (~1.5m shutoff head) fails at
    1m lift. Documents head-flow curve constraint, updated pump spec to 10W
    with min. 3m max head. Corrects energy budget accordingly (10W pump,
    realistic 4 min/day vs. old 30 min estimate). XL6009 remains viable
    at I_in ≈ 3.4A but flagged for thermal validation.
2026-05-28 ADR-004: Switch to drip irrigation — eliminates 12V boost converter
    Drip system (1-3W, 3.7-5V pump) validated by Gardena AquaBloom (1W/3.6V/4m
    head/10 L/h). XL6009 boost converter removed from BOM. Pump cost drops from
    12€ to 5-8€; adds drip hardware (~8€). Net BOM neutral, circuit simpler.
    Autonomy without sun improves from ~21 to ~56 days. ADR-003 updated to
    reflect new pump spec (3-5V, not 12V).
2026-05-28 Add controller standby to energy budget; expose TTGO LDO quiescent current
    TTGO board deep sleep is ~5.5mA (not 0.01mA) due to AMS1117 LDO (5mA
    quiescent) and CP2104 USB-UART chip. Standby dominates energy budget at
    ~460 mWh/day — more than pump (270 mWh) + LoRa TX (180 mWh) combined.
    Custom PCB with MCP1700 LDO reduces standby to ~4 mWh/day (115× better).
    Validated by Gardena AquaBloom analysis: same pattern, standby > pump.
2026-05-28 Add Guard competitive analysis; swap roadmap to Guard-first
    competitive-analysis.md: Full Guard section added — GSM alarms,
    Daitem D22, VisorTech Solar, YoLink, 4G wildlife cameras. Matrix
    shows SmartGarden Guard is only solution combining solar + push app
    + no hub/WiFi on-site + zero monthly costs. Critical assumptions
    for field validation documented.
    product-strategy.md: Roadmap swapped — Guard Home prototype moves
    to v0.2 (simpler hardware, validates LoRaWAN pipeline, blue ocean),
    Garden Home moves to v0.3 (benefits from validated pipeline, spring
    2027 launch window).
2026-05-28 Guard PoC v0.2: TTGO LoRa32 + PIR → LoRaWAN → TTN → ntfy.sh push
    Complete PlatformIO project for Guard Home PoC:
    - main.cpp: PIR interrupt (GPIO13, RISING) → LMIC OTAA → 2-byte uplink
    (alert type + counter), 60s cooldown, LED feedback
    - platformio.ini: MCCI LMIC only (no display libs needed for Guard)
    - secrets.example.h: TTN OTAA credentials template
    - README.md: full setup guide — wiring, HC-SR501 5V caveat,
    TTN device registration, ntfy.sh webhook config, test procedure
    Known PoC limits: no deep sleep, HC-SR501 needs USB 5V,
    no watchdog. Deep sleep + AM312 + watchdog in v0.3.
2026-05-29 Fix OLED_RST pin, add LMIC config and sensor node setup guide
    - Fix OLED_RST 16 -> -1 (Pin 16 intern belegt auf TTGO, verursachte Watchdog-Reset)
    - lmic_project_config.h mit CFG_eu868, SX1276, Interrupts
    - Setup-Guide docs/architecture/setup-sensor-node.md: TTN-Onboarding,
    Byte-Reihenfolge der Keys, bekannte Probleme, Downlink-Kommandos
    [main.cpp]
2026-05-29 Add HC-SR501 PIR motion sensor with polling and pending uplink
    - PIR auf GPIO 13 (HC-SR501, 5V, Jumper L, Polling statt Interrupt)
    - Zustandsaenderung (ALARM/KLAR) loest sofortigen Uplink aus
    - Payload Byte 1: 0x01 = Bewegung, 0x00 = klar
    - motionPending Flag sendet KLAR-Uplink nach TX-Abschluss
2026-05-29 Revert main.cpp to pre-PIR version (OLED fix only)
    [main.cpp]
2026-05-29 Re-add PIR motion sensor with simple polling (no pending counter)
2026-05-29 Add Flutter mobile app with TTN MQTT live status and LED control
    - MQTT Verbindung zu TTN eu1 (Port 8883, TLS)
    - Live-Anzeige: LED-Status und Bewegungsalarm
    - LED-Steuerung per Downlink (AN/AUS/Toggle)
    - API Key ausgelagert in secrets.dart (gitignored)
    - secrets.example.dart als Vorlage eingecheckt
2026-05-30 Switch Flutter Web App to Firebase RTDB polling + add architecture docs
    - main.dart: MQTT ersetzt durch HTTP polling auf Firebase Realtime Database
    - Status-Update alle 10s via REST GET auf Firebase RTDB
    - LED-Steuerung via TTN REST API (HTTP POST mit Bearer Token)
    - Neuer Datenfluss: Node -> TTN Webhook -> Firebase RTDB -> Flutter App
    - webapp-architecture.md: Architekturdiagramm, Sequenzdiagramme,
    Payload-Format, Deployment-Anleitung
2026-06-04 Add US-024 IP65 protection requirement for Guard Node outdoor housing
2026-06-04 Add Arduino sketch, sync LMIC_setClockError fix to both versions
    - firmware/sensor-node/arduino/: Arduino IDE Version des Sketches
    - firmware/sensor-node/arduino/secrets.example.h: Key-Template
    - firmware/sensor-node/src/main.cpp: LMIC_setClockError(10%) ergaenzt
    (RX-Fenster breiter fuer zuverlaessigeren Join auf ESP32)
    [SmartGardenNode.ino, secrets.example.h]
2026-06-04 Remove LMIC_setClockError, fix Firebase latest entry sorting in Flutter App
    - Entferne LMIC_setClockError (verlangsamt Zyklus, war nicht noetig)
    - Flutter App: neuesten Eintrag per received_at sortieren statt entries.last
    - Gilt fuer src/main.cpp und arduino/SmartGardenNode.ino
    [SmartGardenNode.ino, main.cpp]
2026-06-04 Add Deep Sleep + PIR Wakeup + RTC Session Persistence (Guard v0.2)
    - Deep Sleep zwischen Uplinks (15min Timer)
    - PIR GPIO13 weckt ESP32 bei Bewegung sofort auf (steigende Flanke)
    - Session-Keys werden im RTC-Speicher gespeichert (ueberlebt Deep Sleep)
    - Kein Re-Join nach Aufwachen -> sofortiger Alarm-Uplink
    - LED-Status bleibt nach Deep Sleep erhalten (RTC_DATA_ATTR)
    - Wakeup-Grund wird erkannt (PIR/Timer/Reset)
    - Erster Boot: OTAA Join, danach nur noch RTC-Session
    Stromverbrauch-Schaetzung:
    - Aktiv (TX): ~300mA fuer ~2s alle 15min
    - Deep Sleep: ~0.15mA
    - Durchschnitt: ~0.5mA -> 2x18650 ~400 Tage
    [SmartGardenNode.ino]
2026-06-04 Fix LMIC_setSession API call and artKey typo in Guard v0.2
    - LMIC_setSession: netid 0x13 als ersten Parameter ergaenzt
    - LMIC.appKey -> LMIC.artKey korrigiert
    - LMIC_setClockError auf 30% erhoeht fuer zuverlaessigeren Join
    [SmartGardenNode.ino, main.cpp]
2026-06-04 Add US-025 waterproof prototype housing and US-026 WiFi OTA update
    - US-025 [MUST]: Spelsberg IP66 Gehaeuse fuer ersten Prototyp
    inkl. PIR-Optionen, Durchfuehrungen, Materialkostenschaetzung ~23 EUR
    - US-026 [SHOULD]: OTA Firmware-Update via WiFi bei USB-C Wartung
2026-06-04 Add PoC wiring documentation for TTGO LoRa32 V2.1
    - HC-SR501 PIR Verdrahtung (5V, GPIO13, Jumper L)
    - BME280 geplante Verdrahtung (I2C shared mit OLED)
    - I2C Bus Belegung Tabelle
    - Pin-Belegung aktueller PoC
    - Wichtige Hinweise HC-SR501 vs AM312
2026-06-04 Improve Guard v0.2 sleep behavior after TX
    - Nach TX: 10s wach bleiben fuer Downlinks, dann Deep Sleep
    - Bei aktivem PIR-Alarm: alle 30s Uplink senden bis Alarm vorbei
    - PIR-Status beim Timer-Wakeup pruefen (falls Bewegung waehrend Sleep)
    - Serial log fuer PIR-Status beim Start
2026-06-04 Fix PIR HIGH bug before Deep Sleep
    - Problem: ESP32 schlaeft wenn PIR=HIGH -> keine steigende Flanke
    -> Wakeup durch EXT0 unmoeglich solange PIR HIGH bleibt
    - Fix: vor Deep Sleep warten bis PIR=LOW (fallende Flanke)
    - Sicherheits-Timeout nach 5 Minuten (dauerhafter Alarm)
    - OLED zeigt 'Warte auf KLAR' waehrend des Wartens
    [SmartGardenNode.ino]
2026-06-04 Replace lambda with named function triggerSleep() for readability
    [SmartGardenNode.ino]
2026-06-04 Add max alarm uplink limit to prevent endless active state
    - MAX_ALARM_UPLINKS = 5 (nach 5 Alarm-Uplinks erzwungener Sleep)
    - rtcAlarmCount im RTC gespeichert (ueberlebt Deep Sleep)
    - OLED zeigt Alarm-Counter (z.B. Alarm 3/5)
    - Verhindert Duty-Cycle-Erschoepfung bei dauerhaft aktivem PIR
    [SmartGardenNode.ino]
2026-06-04 Fix EU868 channels missing in RTC session restore path
    - LMIC_setupChannel fuer alle 9 EU868 Kanaele vor beiden Pfaden gesetzt
    - Gilt jetzt fuer OTAA Join UND RTC-Session-Restore
    - Verhindert falsches Kanalverhalten nach Deep Sleep Wakeup
    [SmartGardenNode.ino]
2026-06-04 Update state machine docs for Guard v0.2 with Deep Sleep
    - Haupt-State Machine: Deep Sleep Zyklus komplett neu
    - Wakeup-Logik Flowchart (PIR/Timer/Reset)
    - Alarm-Logik Flowchart (alarmCount, triggerSleep)
    - RTC-Speicher Tabelle mit Erklaerung
    - Energiebudget (~90 Tage mit 2x18650)
    - Bekannte Einschraenkungen mit Status
2026-06-07 Guard v0.2: Rejoin after each sleep instead of RTC session restore (#1)
    * Replace RTC session restore with fresh OTAA join after each sleep
    RTC-persisted LoRaWAN sessions caused uplinks to be silently dropped by
    the network server (frame-counter/channel-state mismatches after deep
    sleep restore). With the node's own gateway in range, a fresh OTAA join
    on every wakeup is fast and far more reliable, so session persistence
    was removed in favor of always rejoining.
    Also fixes motionAlert being read only once at boot: the PIR pin is now
    re-read before deciding whether to send another alarm uplink or sleep,
    so a cleared PIR state correctly stops the alarm escalation.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
    [SmartGardenNode.ino]
2026-06-20 Document LILYGO T3_V1.6.1 board variant and pinout
2026-06-20 Add irrigator pump test firmware and document hardware bring-up findings
    Pump and MOSFET switching circuit verified working; current boost
    converter is undersized and needs replacement (e.g. XL6019 5A) before
    battery operation can be tested.
    [IrrigatorPumpTest.ino, main.cpp]
2026-06-20 Document actual QWORK 12V pump model in actuator BOM table
2026-06-20 Note submersible vs. dry-housing self-priming pump as open design question
2026-06-21 Add Onherm competitor reference and test self-priming pump alternative
    Tested a small centrifugal DC pump as a dry-housing substitute for the
    submersible pump — it cannot self-prime, confirming the submersible
    12V pump remains the pragmatic choice unless switching to a diaphragm
    or peristaltic pump.
2026-06-21 Clarify use case as 2x2m raised bed, not individual potted plants
    Drip layout should be a grid of soaker lines across the bed area
    rather than per-plant emitters, which raises total flow requirements
    and further justifies keeping the 12V submersible pump.
2026-06-21 Finalize pump decision: 12V submersible pump + boost converter
    Closes the open evaluation between drip pump, diaphragm pump, and
    peristaltic pump alternatives. Accepts the boost converter and inline
    filter as additional BOM cost, justified by the raised-bed/tomato use
    case exceeding Gardena AquaBloom's class. Next step is a field test.
2026-06-21 Revise pump decision: test YWBL-WH mini diaphragm pump as boost-free alternative
    Self-priming 3-3.7V diaphragm pump works without a boost converter and
    confirmed at 50cm lift through 1.5m hose. Flagged that its 1.5m max
    head matches the upper end of the required operating point, so flow
    at full operating height (1.3-1.5m) still needs to be measured before
    fully replacing the 12V pump + boost approach.
2026-06-21 Add Garden Home pricing validation table with no-name price anchor
    Captures the unresolved question of whether customers pay a premium
    for remote irrigation monitoring, with a price anchor table (20-30€
    no-name vs. 85-95€ SmartGarden target) and concrete validation tests.
2026-06-27 Add LoRaWAN-enabled irrigator firmware and Flutter app integration
    Irrigator node now reports pump status and soil moisture via TTN,
    mirroring the Guard node's setup. Adds a Bewässerung section to the
    Flutter app showing pump state and soil moisture percentage.
    Also widens the secrets.h gitignore pattern (firmware/**/secrets.h)
    to cover Arduino sketch folders too, and untracks a secrets.h that
    was previously committed with real (since-superseded) TTN credentials.
2026-06-28 Document DynamoDB overwrite behavior vs Firebase's implicit history
    PutItem with device_id as the sole partition key replaces the prior
    record entirely, unlike Firebase where each webhook POST appends a
    new push-key child. Notes the schema fix needed before this backend
    could support historical sensor data (US-007).
2026-06-28 Document solar charging setup: LiebeWH panel + CN3065 charger module
    Captures panel/charger specs, wiring plan, and the first successful
    charge test (status LED confirms charging). Flags the load-output
    current limit as still needing verification before running the pump
    off the charger's load port.
2026-06-28 Document drip system components: filter, reducer, Gardena tube, intake strainer
    Pump hose (6mm ID / 8mm OD) doesn't match standard irrigation sizing
    (4mm/4.6mm or 13/16mm), so documents the bridging components found
    and a DIY weighted intake strainer since no off-the-shelf product
    exists for this hose size.
2026-07-18 Add battery voltage measurement + Deep Sleep (PoC v0.4)
    - Firmware: GPIO35 ADC reads battery voltage via analogReadMilliVolts()
    with 5.5kΩ/5.5kΩ voltage divider; payload extended to 5 bytes
    (Byte 3-4: Vbat in mV, big-endian)
    - Firmware: Deep Sleep after each TX (55s, configurable via TX_INTERVAL_SEC);
    pump state persists in RTC RAM; pump running → stay awake, check every 15s
    - App: decode bytes 3-4 as batteryMv in both Firebase and AWS paths;
    new battery status card with LiPo% calculation (3000mV=0%, 4200mV=100%)
    and color thresholds (<15% red, <30% orange, ≥30% green)
    - secrets.example.h updated for OTAA (placeholder values)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
2026-07-18 Update IrrigatorNode.ino
    Anpassung für Arduino Umgebung
2026-07-18 Revert to OTAA, set TX interval to 15 min (PoC v0.4)
    ABP tested but abandoned — TTN v3 recommends OTAA and ABP frame
    counter enforcement caused unreliable delivery. Back to OTAA with
    TX_INTERVAL_SEC=900 (~96 joins/day, acceptable for garden PoC).
    [main.cpp]
2026-07-18 Add Irrigator Node v0.4 state machine to firmware-state-machine.md
    Mermaid stateDiagram with all 6 states (BOOT, JOINING, MEASURING,
    TRANSMITTING, PUMPING, SLEEPING), transitions, timing, payload format
    and RTC-RAM documentation.
2026-07-18 Add smartgarden-watchdog Lambda (Heartbeat-Monitoring)
    EventBridge triggers every 5min → Lambda checks DynamoDB received_at
    per device → SNS alert if silent > TIMEOUT_SEC (default 30min).
    Separate from smartgarden-read: different trigger (schedule vs HTTP),
    different IAM (adds sns:Publish), independent failure domain.
    Includes README with IAM policy, SNS setup, EventBridge scheduler
    and Cloud-Architecture rationale for separation.
2026-07-18 Add cloud architecture diagram as Mermaid
    Dokumentiert den kompletten Stack: ESP32 → LoRaWAN → TTN → AWS
    (Lambda, DynamoDB, API Gateway, EventBridge, SNS) → Flutter App.
2026-07-18 Fix cloud diagram: add smartgarden-write Lambda
    lambda-write empfängt TTN-Webhook POST und schreibt in DynamoDB —
    war fälschlicherweise als ttn-webhook benannt.
2026-07-18 Fix cloud diagram: API Gateway only routes to read Lambda
    Write Lambda wird direkt von TTN per HTTP Webhook aufgerufen,
    nicht über API Gateway. API Gateway → nur smartgarden-read.
2026-07-19 Fix Android build and scrollable layout
    Gradle 8.14, AGP 8.6, Kotlin 1.9.25 für Flutter 3.44 Kompatibilität.
    Column in SingleChildScrollView gewrappt — kein Overflow mehr auf kleineren Bildschirmen.
