Silverlode76/SmartGarden/(notices)

Notices in the files:
firmware/v0.0-stm32-node/Core/Inc/main.h:
Copyright (c) 2024 STMicroelectronics.
All rights reserved.
This software is licensed under terms that can be found in the LICENSE file
README.md:
License: MIT
